mehstg/dimepi/pi_carrier.stl

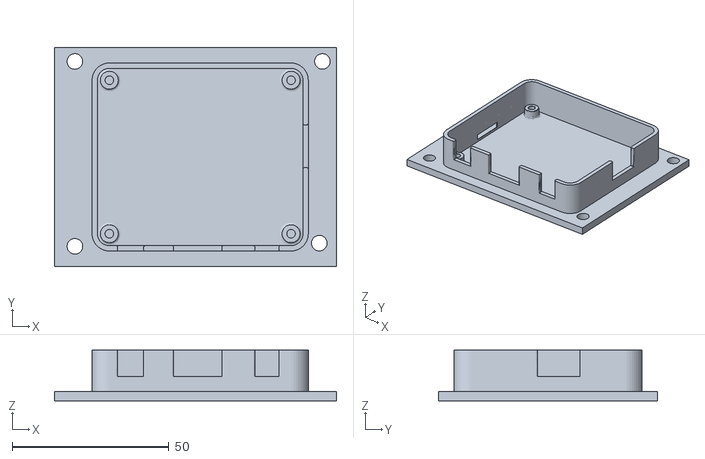
[picture p5: CAD file, 2026-05-12]
pi_carrier.stl
90.0 x 70.0 x 16.3
