mehstg/dimepi/CHANGELOG.md

# Changelog

## [2.3.0](https://github.com/mehstg/dimepi/compare/v2.2.0...v2.3.0) (2026-05-21)

### Features

* Add support for queue clearing when Sonos is on external source ([#29](https://github.com/mehstg/dimepi/issues/29)) ([deee52e](https://github.com/mehstg/dimepi/commit/deee52e08b01760cc0dbfa3bdd19c9c9cad256e6))

### Bug Fixes

* Sonos playlist deletion error ([#27](https://github.com/mehstg/dimepi/issues/27)) ([ded8c0b](https://github.com/mehstg/dimepi/commit/ded8c0b4c193dfc5cbf2c7a3efcd29530b83f098))

## [2.2.0](https://github.com/mehstg/dimepi/compare/v2.1.0...v2.2.0) (2026-05-13)

### Features

* Sonos API wired to work with the web frontend ([#23](https://github.com/mehstg/dimepi/issues/23)) ([6415e70](https://github.com/mehstg/dimepi/commit/6415e70333d18d36222498c469501931f4381154))

## [2.1.0](https://github.com/mehstg/dimepi/compare/2.0.0...v2.1.0) (2026-05-13)

### Features

* Add credit display and control to UI ([#19](https://github.com/mehstg/dimepi/issues/19)) ([0f9d114](https://github.com/mehstg/dimepi/commit/0f9d114a2f119e5be1c214ac18bed17680589c4c))
* Add in release please for releases ([#24](https://github.com/mehstg/dimepi/issues/24)) ([8ebae10](https://github.com/mehstg/dimepi/commit/8ebae10b3c9e8a0ade15194f2f8d0fc495036fc7))
* Add sonos section in to web ui ([#21](https://github.com/mehstg/dimepi/issues/21)) ([b486ad3](https://github.com/mehstg/dimepi/commit/b486ad3bb5359171576f7201844a1baa71d0b757))

### Bug Fixes

* Credit handler not updating when UI makes change ([#20](https://github.com/mehstg/dimepi/issues/20)) ([48412f7](https://github.com/mehstg/dimepi/commit/48412f708c95f23e13754fd52cca67b1ef9e75ff))
* revert config.ini changes in api ([#22](https://github.com/mehstg/dimepi/issues/22)) ([175c21d](https://github.com/mehstg/dimepi/commit/175c21db4f628fea4efb828769ed13378cb1812d))

## [2.0.0] - 2026-05-12

- Existing release baseline before adopting `release-please`.
