mehstg/dimepi/(commit log)

2022-06-10 added sample logic for track selection
2022-06-11 add track search logic, also move key mappings inside keypad class
2022-06-13 add in track mapping logic
2022-06-19 initial tinkering. Adding neopixels for case lighting
2022-06-21 add queue clearance code
    [database.py, main.py, sonos_interface.py]
2022-06-22 fix incorrect log line
    [main.py]
2025-06-16 Feature/keypad retry (#7)
    * fix keypad retry logic and other bugs
    [database.py, keypad.py, main.py]
2025-06-17 fix logging config (#10)
    * fix logging config
    * add sys library
    ---------
    [main.py]
2025-06-17 Logging (#11)
    * updated logging
    * getcredits not in class
    * update lights off time
    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
    [database.py, main.py]
2025-06-17 fix logging race condition (#12)
    [database.py]
2026-05-10 feat!: Add admin UI and live cabinet light settings (#17)
    * Add containerized admin UI
    * Update main app runtime behaviour
    * Slim main app image build
    * Fix remote service build contexts
    * Use glibc node builder for frontend
    * Sort track keys naturally
    [cabinet_lights.py, database.py, main.py, sonos_interface.py]
2026-05-12 fix: update to use nullpool (#18)
    [database.py, main.py]
2026-05-12 fix: Credit handler not updating when UI makes change (#20)
    [main.py]
2026-05-12 fix: revert config.ini changes in api (#22)
    [main.py]
2026-05-13 feat: Sonos API wired to work with the web frontend (#23)
    * add in sonos controls
2026-05-16 fix: Sonos playlist deletion error (#27)
    * fix: Remove single track deletion complete
